DTABH/VFD_Watch/README.md

# Changes DTABH :

**FW_VERSION "2.0.0 dtabh"**

<ul>
  <li> 
    As a wristwatch, it was to big for me and with a neccessary WLAN and fixed network parameters not practical. <br>
    So i will make/made a small desktop watch adding some things like .....
  </li> 
 <li>Implemented  a cheap china RTC Modul (see Pictures) using second I2C-bus  Wire1.setPins(27, 14);  <br>
    I tried first existing SDA and SCL used for the clock multiplexer. But this doesn't work <br>
    If a NTP connection exists, the time from NTP will be used (RTC is synchonized). <br>
    If NTP fails RTC ist used. If no WLAN-connection exists the RTC-Only mode is activated. <br>
    Time and date can/must be set via middle button  (BTN1) 
  </li>
  <li> 
    Both dots changing on off every second
  </li>
  <li> 
    Add Showdate every 30 seconds with only lower dot on. On/Off toggle via right button.
  </li>  
   <li> 
    Add Wifimanager to configure wifi connnection, ntpserver and timezone,
  </li> 
  <li> Extended the menu. <br>
      Menu starting with long pressed button <br> 
    
      Button Left (BTN0)    >= 3 seconds  Start accesspoint of  Wifimanager with existing configuration 
                            >= 6 seconds  Delete configuration and Start accesspoint of  Wifimanager. (Reset)
    
      Button Middle (BTN1)  >= 3 seconds  set RTC_only and opens manual input menu for "minutes, hours" (both dots on)
                                          and if showdate is activated  for "day of month, month" (only lower dot is on)
                                          and "year" (no dots)                                        
                            >= 6 seconds  unset RTC_only set manual/RTC time to begin of unixtime and restart the ESP 
                                          which then opens the accesspoint of wifimanager (Reset)
                            
      Button Right (BTN2)   >= 2 seconds Toggle showdate.     
  </li>

</ul>
<br>  <br>  <br>  

**Images:**

RTC-Module "stable" connected to ground with 1,5mm" cooper wire.

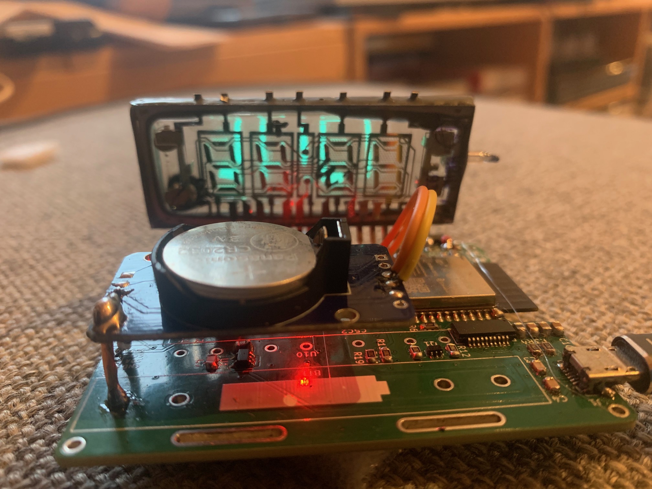
[picture p1: Graphics/IMG_1260.jpg]
 

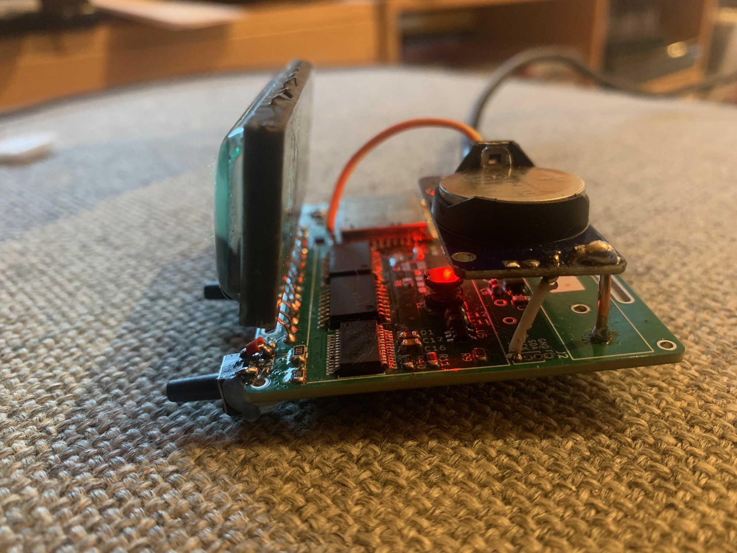
[picture p2: Graphics/IMG_1261.jpg]
  

Shows date for 2 seconds every 30 seconds (low dot only)

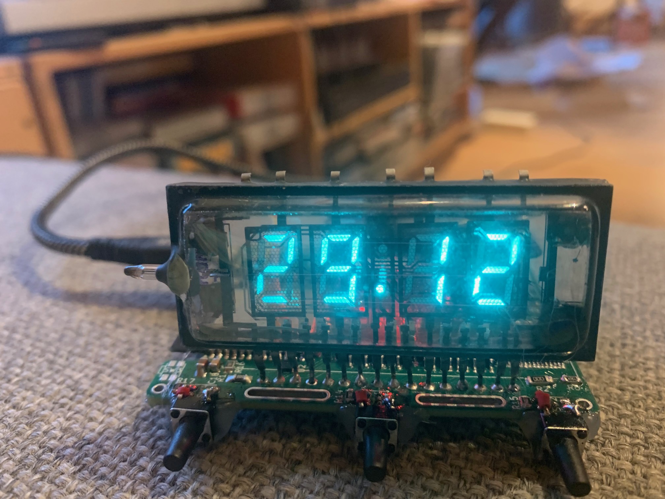
[picture p3: Graphics/IMG_1264.jpg]
  

<br>  <br> <br>  <br>  

**Remarks:**

The source code has become a bit messy. Sorry but it works for me.  <br> 
Especially switching between WLAN/NTP and only RTC. Timezone an no timezone etc.  <br> 
let me make it too complex. There is possible improvement. But not for me.  <br> 
<br>  <br> <br>  <br>  

# original readme -----------------------------------------------------------

# VFD Watch Project

This project was originally inspired by Johngineer's [ChronodeVFD](https://blog.adafruit.com/2014/10/29/chronodevfd-a-watch-by-johngineer-wearablewednesday/) project. However no concrete design information were available therefore this project was born.

The goal was to create a mobile driver circuit for the common IVL2-5/7 vacuum fluorescent display, that is powered by a single cell battery. The datasheet of the display can be found on the [Loststreak](http://loststeak.com/ivl2-75-vfd-datasheets/) blog.

## Circuit elements

### Microcontroller
An **ESP32 WROOM-32** module is used as a microcontroller for the display and wireless communication. It is interfaced fo r programming via a **FT231XS** USB-Serial converter.

### Battery voltage regulation
The choice for the battery driver IC fell on the **MP3120** single cell 1.2A step up module as it can handle very low battery voltages and still start up. If wireless communication is used during the power up of the display the step-up module won't be able to supply enough power from a normal Alkaline cell to the ESP32 and a brownout reset will occur. Primary lithium cells, 2 Alkaline batteries or LiIon should be sufficient to power all functions at the same time.

Schematic of the 3.3V supply

### VFD driver
The display is driven by a 24V rail from a **MCP1663** step-up converter and high-side switches (**TBD62783A**) to power the segments. The filament is driven from the 3.3V rail and pulse-modulated from a motor H-bridge driver (**DRV8837C**) to achieve an equivalent to the 2.4V @ 60mA power conditions described in the datasheet. The H-bridge design allows an equal brightness of the characters without the use of a complex center-tapped AC circuit.

Schematic of the 24V supply

## Software

### Functions

```cpp
void begin(uint8_t dutyCycle, uint32_t freqMultiplex, uint32_t freqHeat)
```

* ```dutyCycle``` sets the PWM duty cycle of the heating filament. 0-255; typical 120.
* ```freqMultiplex``` sets the rate at which the characters are cycled though (1kHz -> 200Hz total refresh of the display). The timing is controlled in the background by an interrupt function that calls for an update of the currently displayed character. This process runs on core 0 of the ESP32, therefore during WiFi use the display can flicker a bit.
* ```freqHeat``` sets the frequency of the heating filament PWM. The value should be in the kHz range.

```cpp
void deactivate()
```
Turns of the heating filament and the 24V rail to preserve power.

```cpp
void activate()
```
Turns the display back on after a ```deactivate()```.

```cpp
void setHours(uint8_t hours)
```
Sets the first two digits. Range 0-99.

```cpp
void setMinutes(uint8_t minutes)
```
Sets the last two digits. Range 0-99.

```cpp
void setCharacter(char character, int pos)
```
Displays a char (```a-z; 0-9; '-'```) at position ```pos``` (```0-3```)

```cpp
void print(char* text)
```
Similar to ```setCharacter()``` but it displays the first 4 chars of the array.

```cpp
void setSegment(uint8_t segments, uint8_t pos);
```
Sets specific segments of a digit through the use of a byte mask (least to most significant bit). E.g. ```0b00101000``` would set segments ```d``` & ```f```. ```pos``` declares the digit to be changed (```0-3```).
