DTABH/VFD_Watch/Graphics/IMG_1267.jpg

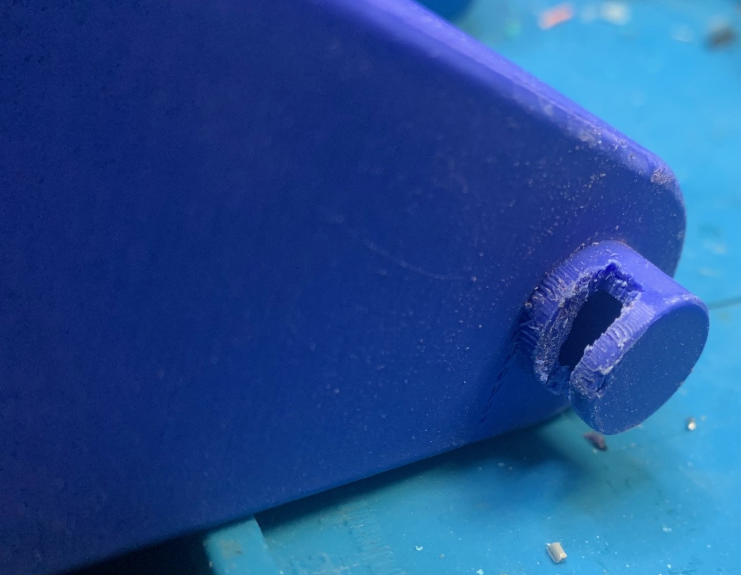
Graphics/IMG_1267.jpg
