DTABH/VFD_Watch/Graphics/IMG_1268.jpg

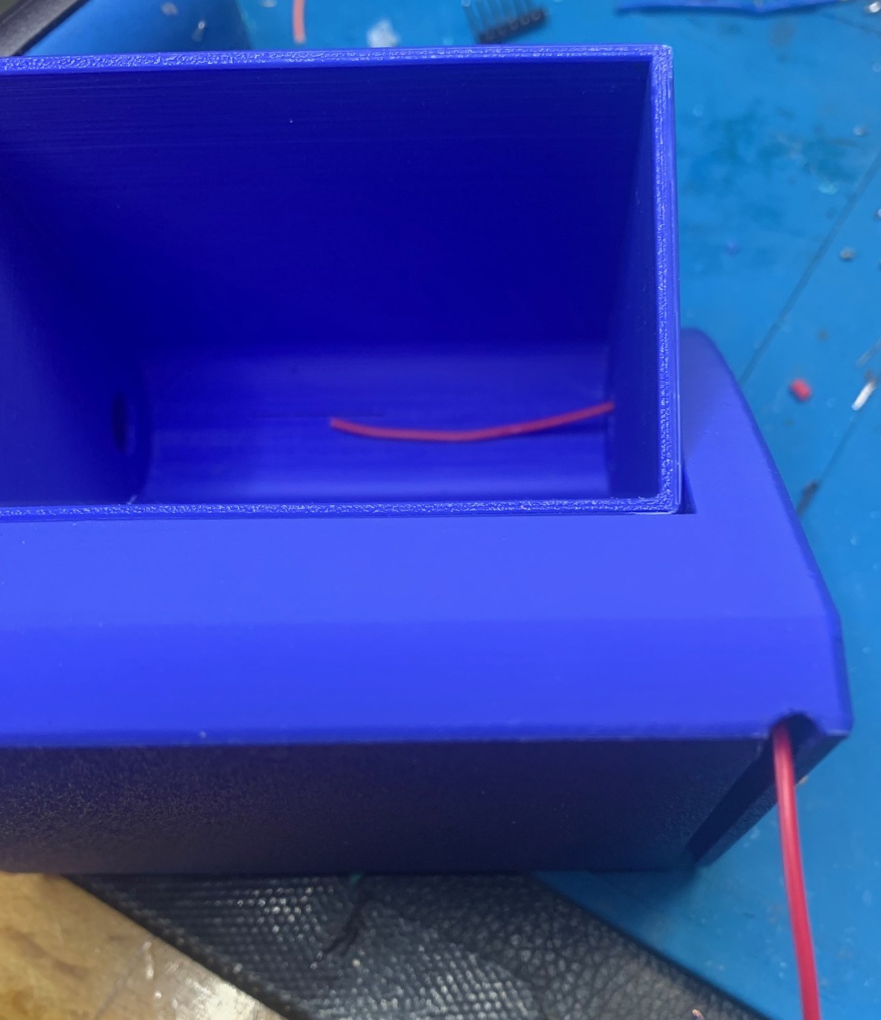
Graphics/IMG_1268.jpg
