DTABH/VFD_Watch/Graphics/IMG_1269.jpg

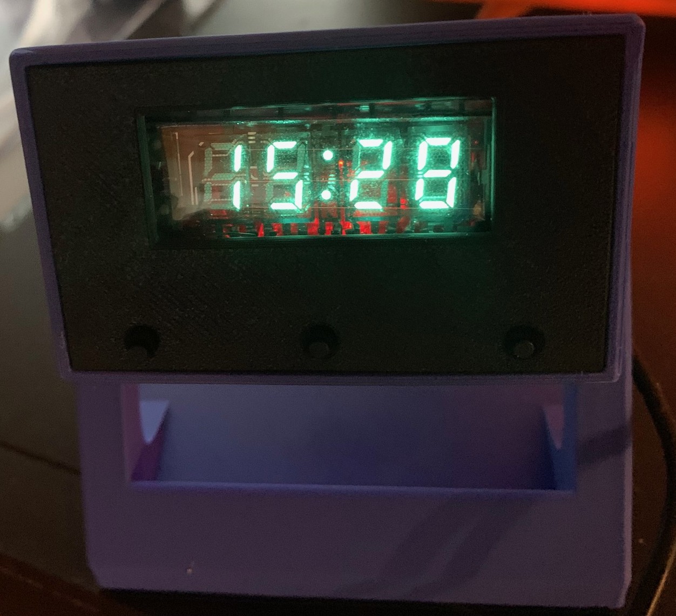
Graphics/IMG_1269.jpg
