DTABH/VFD_Watch/Graphics/IMG_1271.jpg

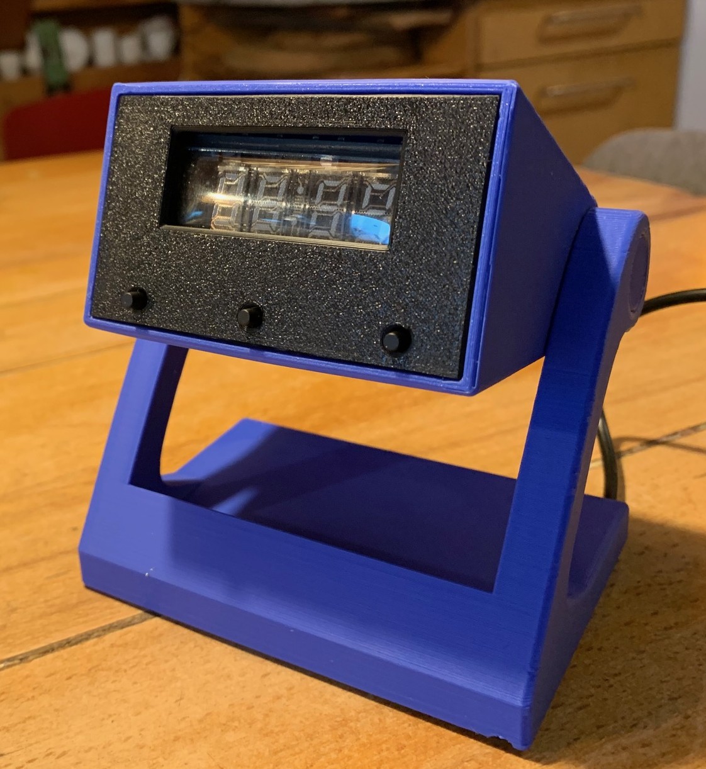
Graphics/IMG_1271.jpg
