DTABH/VFD_Watch/Graphics/IMG_1272.jpg

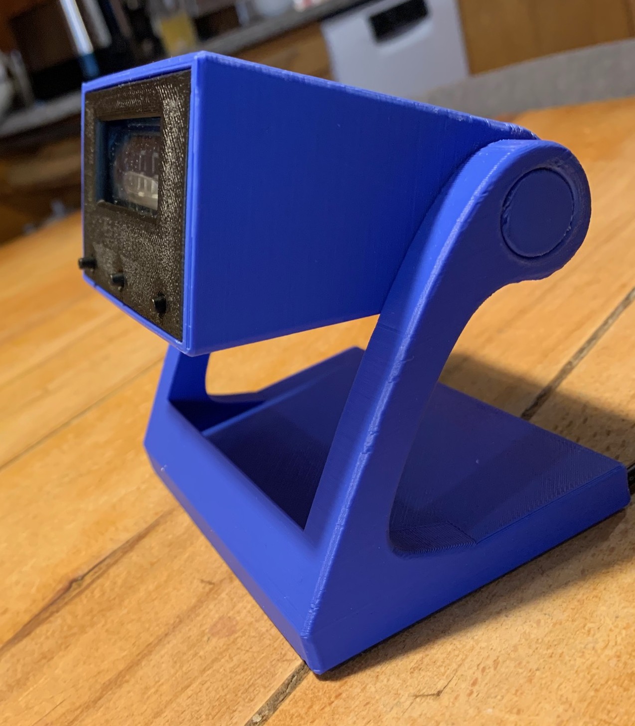
Graphics/IMG_1272.jpg
