DTABH/VFD_Watch/Graphics/IMG_1273.jpg

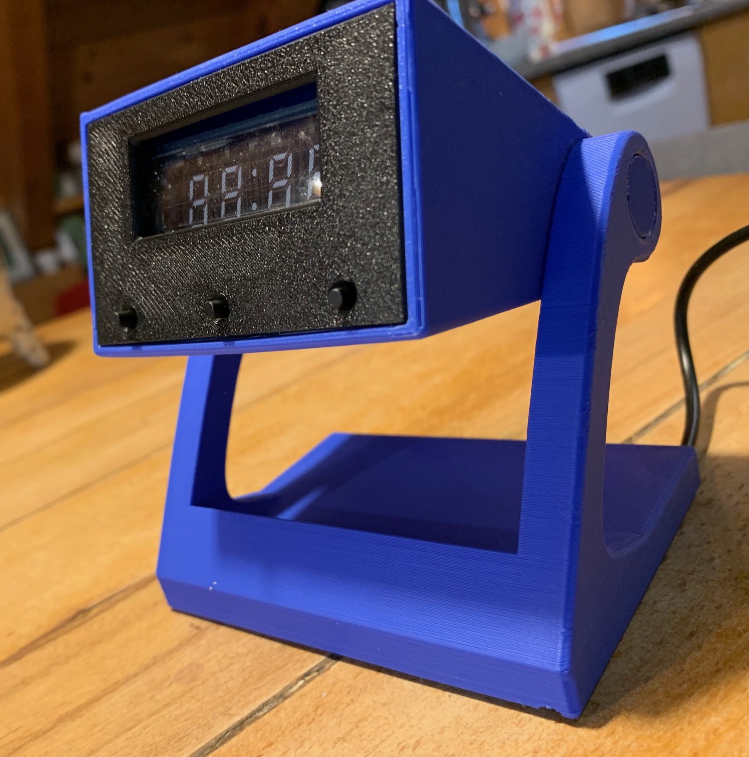
Graphics/IMG_1273.jpg
